Ian-Blockmans/auto-leveling-caravan-prototype/README.md

# auto leveling caravan
prototype met een stm32 controller. prototype werkt maar het is geen afgewerkt product
