Ian-Blockmans/auto-leveling-caravan-prototype/img-vid/IMG_20200525_162942.jpg

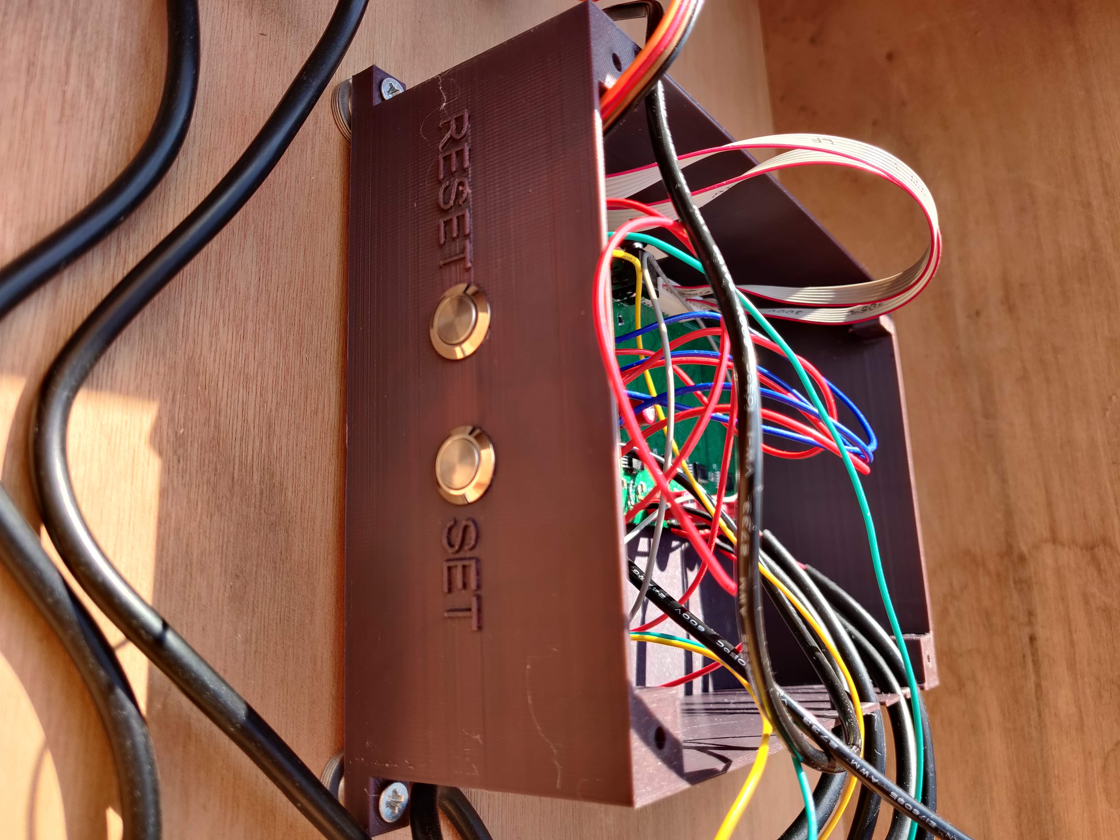
img-vid/IMG_20200525_162942.jpg
