Ian-Blockmans/auto-leveling-caravan-prototype/PART LIST.txt

https://www.mouser.be/ProductDetail/Lelon/REA101M1HBK-0811P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
https://www.mouser.be/ProductDetail/ON-Semiconductor/MM3Z15VST1G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
motor sfh (van jst)
https://www.mouser.be/ProductDetail/CUI-Devices/PJ-082BH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
