Ian-Blockmans/auto-leveling-caravan-prototype/kicad/ent/ent.kicad_pcb

## KiCad design kicad/ent/ent.kicad_pcb (2020-05-05)

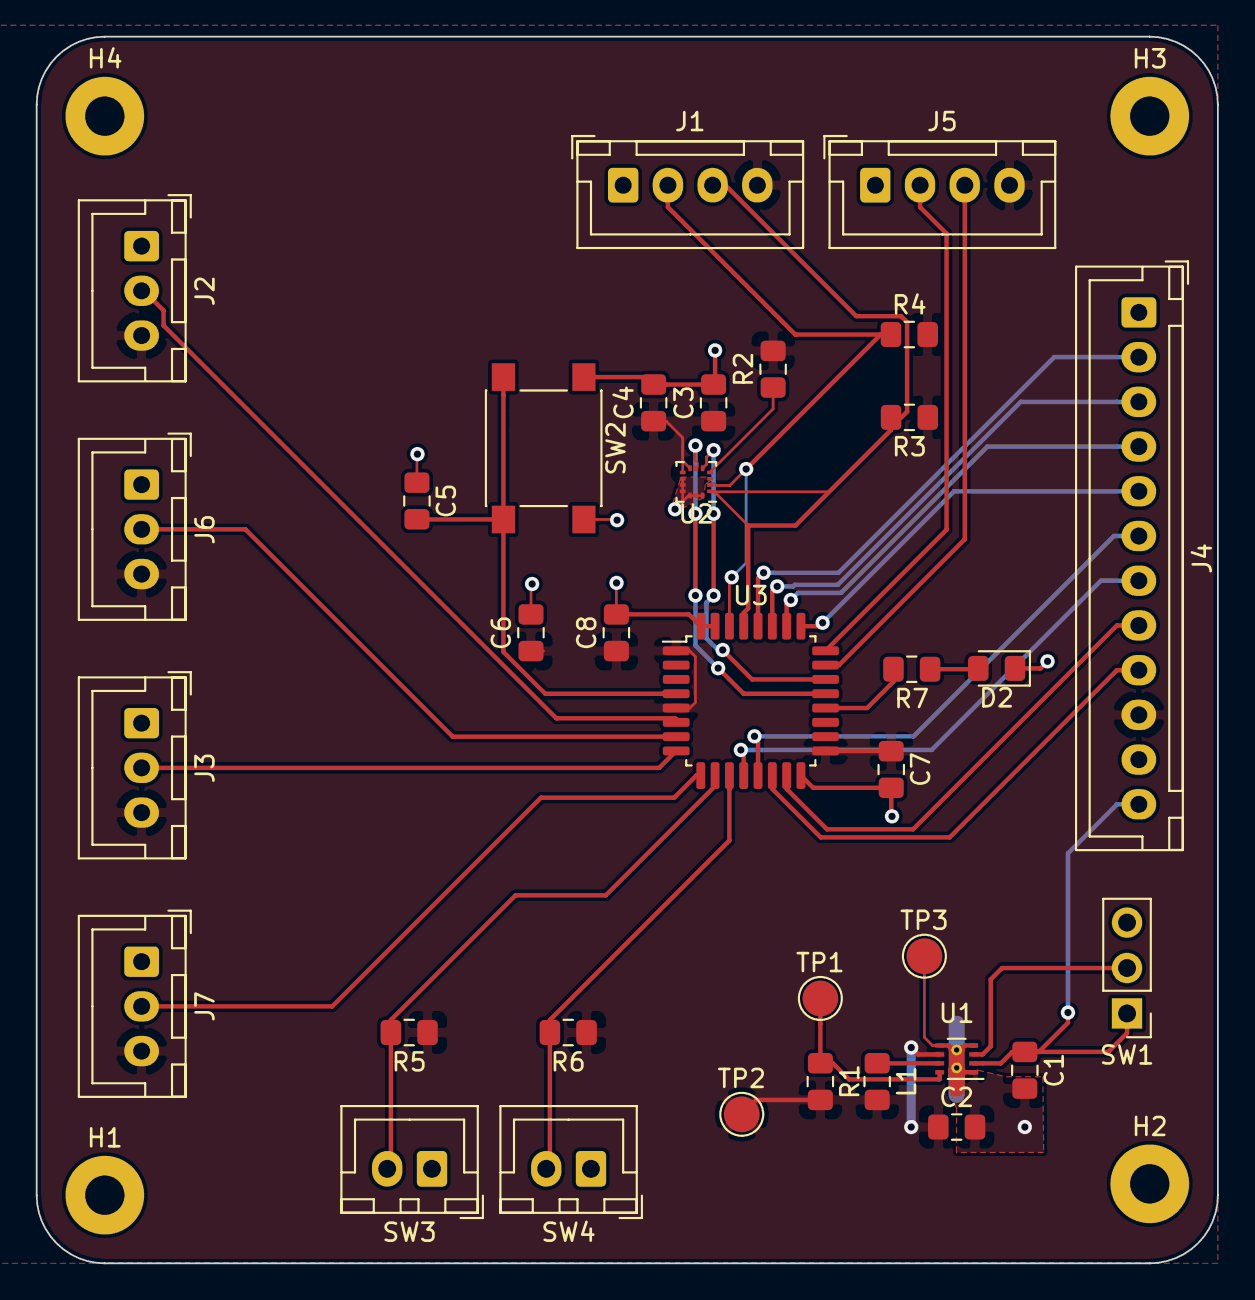
[picture p4: board ent.kicad_pcb from above]

Board: 2 copper layers, 66.0 x 68.6 mm, 38 parts (0 on the bottom side), 30 nets.

Parts:
C1, C3: 10µ; C_0805_2012Metric_Pad1.15x1.40mm_HandSolder
C2: 22µf; C_0805_2012Metric_Pad1.15x1.40mm_HandSolder
C4, C7, C8: 100n; C_0805_2012Metric_Pad1.15x1.40mm_HandSolder
C5: 100nF; C_0805_2012Metric_Pad1.15x1.40mm_HandSolder
C6: 4.7µ; C_0805_2012Metric_Pad1.15x1.40mm_HandSolder
D2: LED; LED_0805_2012Metric_Pad1.15x1.40mm_HandSolder
H1, H2, H3, H4: MountingHole_Pad; MountingHole_2.2mm_M2_Pad
J1, J5: Conn_01x04_Male; JST_XH_B4B-XH-A_1x04_P2.50mm_Vertical
J2, J3, J6, J7: Conn_01x03_Male; JST_XH_B3B-XH-A_1x03_P2.50mm_Vertical
J4: Conn_01x12_Male; JST_XH_B12B-XH-A_1x12_P2.50mm_Vertical
L1: 2.2µH; L_0805_2012Metric_Pad1.15x1.40mm_HandSolder
R1: 100k; R_0805_2012Metric_Pad1.15x1.40mm_HandSolder
R2, R3, R4, R5, R6: 10k; R_0805_2012Metric_Pad1.15x1.40mm_HandSolder
R7: R_Small; R_0805_2012Metric_Pad1.15x1.40mm_HandSolder
SW1: SW_SPDT; PinHeader_1x03_P2.54mm_Vertical
SW2: SW_Push; SW_SPST_PTS645
SW3, SW4: SW_Push; JST_XH_B2B-XH-A_1x02_P2.50mm_Vertical
TP1, TP2, TP3: TestPoint; TestPoint_Pad_D2.0mm
U1: TPS62172DSG; WSON-8-1EP_2x2mm_P0.5mm_EP0.9x1.6mm_ThermalVias
U2: LIS2DHTR; LGA-14_2x2mm_P0.35mm_LayoutBorder3x4y
U3: STM32F030K6Tx; LQFP-32_7x7mm_P0.8mm

Connections:
+12V: C1.1, J4.12, SW1.1, U1.2
Extend: R5.2, SW3.2, U3.10
GND: C1.2, C2.2, C3.2, C4.2, C5.1, C6.2, C7.2, C8.2, D2.1, H1.1, H2.1, H3.1, H4.1, J1.1, J2.1, J3.1, J4.1, J4.11, J5.1, J6.1, J7.1, SW1.3, SW2.1, SW3.1, SW4.1, TP3.1, U1.1, U1.4, U1.5, U1.9, U2.3, U2.9, U2.10, U2.11, U2.12, U2.13, U2.14, U3.16, U3.31, U3.32
INT1: U2.6, U3.21
INT2: U2.5, U3.22
LED: R7.2, U3.20
NSS1: J4.9, U3.14
NSS2: J4.8, U3.15
NSS3: J4.7, U3.12
NSS4: J4.6, U3.13
unnamed: C5.2, SW2.2, U3.4
unnamed: D2.2, R7.1
unnamed: J1.2, R4.1, U2.2, U3.30
unnamed: J1.3, R3.2, U2.1, U3.29
unnamed: J4.5, U3.25
unnamed: L1.1, U1.7
unnamed: R1.1, TP1.1, U1.8
unnamed: R2.1, U2.4
unnamed: SW1.2, U1.3
Retract: R6.2, SW4.2, U3.11
SPI1_MISO: J4.3, U3.27
SPI1_MOSI: J4.2, U3.28
SPI1_SCK: J4.4, U3.26
STOP1: J2.2, U3.6
STOP2: J6.2, U3.7
STOP3: J3.2, U3.8
STOP4: J7.2, U3.9
SWCLK: J5.2, U3.24
SWDIO: J5.3, U3.23
VOS: C2.1, C3.1, C4.1, C6.1, C7.1, C8.1, J1.4, J2.3, J3.3, J4.10, J5.4, J6.3, J7.3, L1.2, R1.2, R2.2, R3.1, R4.2, R5.1, R6.1, TP2.1, U1.6, U2.7, U2.8, U3.1, U3.5, U3.17
