Ian-Blockmans/auto-leveling-caravan-prototype/kicad/ent/motor.kicad_pcb

## KiCad design kicad/ent/motor.kicad_pcb (2020-03-16)

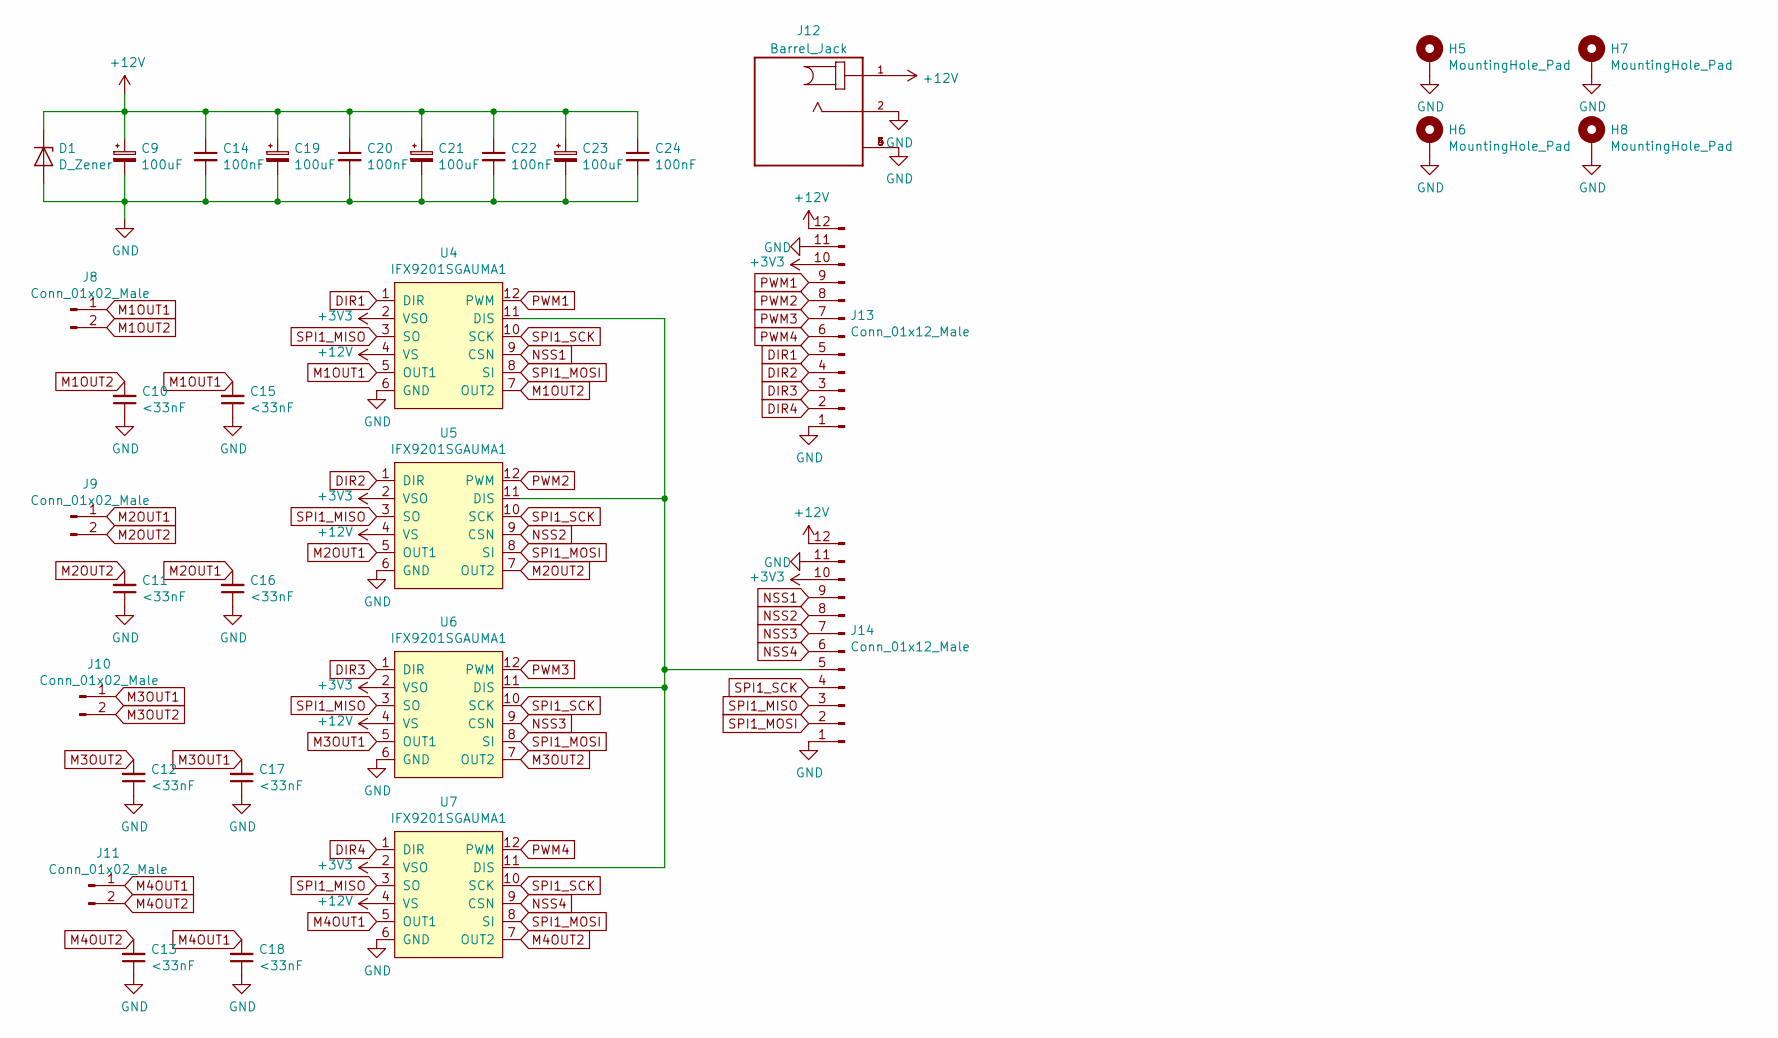
[picture p5: schematic motor.sch]

Parts:
C9, C19, C21, C23: 100uF; CP_Radial_D8.0mm_P3.50mm
C10, C11, C12, C13, C15, C16, C17, C18: <33nF; C_0805_2012Metric_Pad1.15x1.40mm_HandSolder
C14, C20, C22, C24: 100nF; C_0805_2012Metric_Pad1.15x1.40mm_HandSolder
D1: D_Zener; D_SOD-323_HandSoldering
H5, H6, H7, H8: MountingHole_Pad; MountingHole_2.2mm_M2_Pad
J8, J9, J10, J11: Conn_01x02_Male; JST_SFH_SM02B-SFHRS-TF_1x02-1MP_P4.20mm_Horizontal
J12: Barrel_Jack; CUI_PJ-082BH
J13, J14: Conn_01x12_Male; JST_XH_B12B-XH-A_1x12_P2.50mm_Vertical
U4, U5, U6, U7: IFX9201SGAUMA1; PG-DSO-12-17

Connections:
+12V: C9.1, C14.1, C19.1, C20.1, C21.1, C22.1, C23.1, C24.1, D1.1 (K), J12.1, J13.12, J14.12, U4.4 (VS), U5.4 (VS), U6.4 (VS), U7.4 (VS)
DIR1: J13.5, U4.1 (DIR)
DIR2: J13.4, U5.1 (DIR)
DIR3: J13.3, U6.1 (DIR)
DIR4: J13.2, U7.1 (DIR)
GND: C9.2, C10.1, C11.1, C12.1, C13.1, C14.2, C15.1, C16.1, C17.1, C18.1, C19.2, C20.2, C21.2, C22.2, C23.2, C24.2, D1.2 (A), H5.1, H6.1, H7.1, H8.1, J12.2, J12.3 (SHIELD), J12.4 (SHIELD), J12.5 (SHIELD), J12.6 (SHIELD), J12.7, J13.1, J13.11, J14.1, J14.11, U4.6 (GND), U4.13, U5.6 (GND), U5.13, U6.6 (GND), U6.13, U7.6 (GND), U7.13
M1OUT1: C15.2, J8.1, U4.5 (OUT1)
M1OUT2: C10.2, J8.2, U4.7 (OUT2)
M2OUT1: C16.2, J9.1, U5.5 (OUT1)
M2OUT2: C11.2, J9.2, U5.7 (OUT2)
M3OUT1: C17.2, J10.1, U6.5 (OUT1)
M3OUT2: C12.2, J10.2, U6.7 (OUT2)
M4OUT1: C18.2, J11.1, U7.5 (OUT1)
M4OUT2: C13.2, J11.2, U7.7 (OUT2)
NSS1: J14.9, U4.9 (CSN)
NSS2: J14.8, U5.9 (CSN)
NSS3: J14.7, U6.9 (CSN)
NSS4: J14.6, U7.9 (CSN)
unnamed: J14.5, U4.11 (DIS), U5.11 (DIS), U6.11 (DIS), U7.11 (DIS)
PWM1: J13.9, U4.12 (PWM)
PWM2: J13.8, U5.12 (PWM)
PWM3: J13.7, U6.12 (PWM)
PWM4: J13.6, U7.12 (PWM)
SPI1_MISO: J14.3, U4.3 (SO), U5.3 (SO), U6.3 (SO), U7.3 (SO)
SPI1_MOSI: J14.2, U4.8 (SI), U5.8 (SI), U6.8 (SI), U7.8 (SI)
SPI1_SCK: J14.4, U4.10 (SCK), U5.10 (SCK), U6.10 (SCK), U7.10 (SCK)
VOS: J13.10, J14.10, U4.2 (VSO), U5.2 (VSO), U6.2 (VSO), U7.2 (VSO)

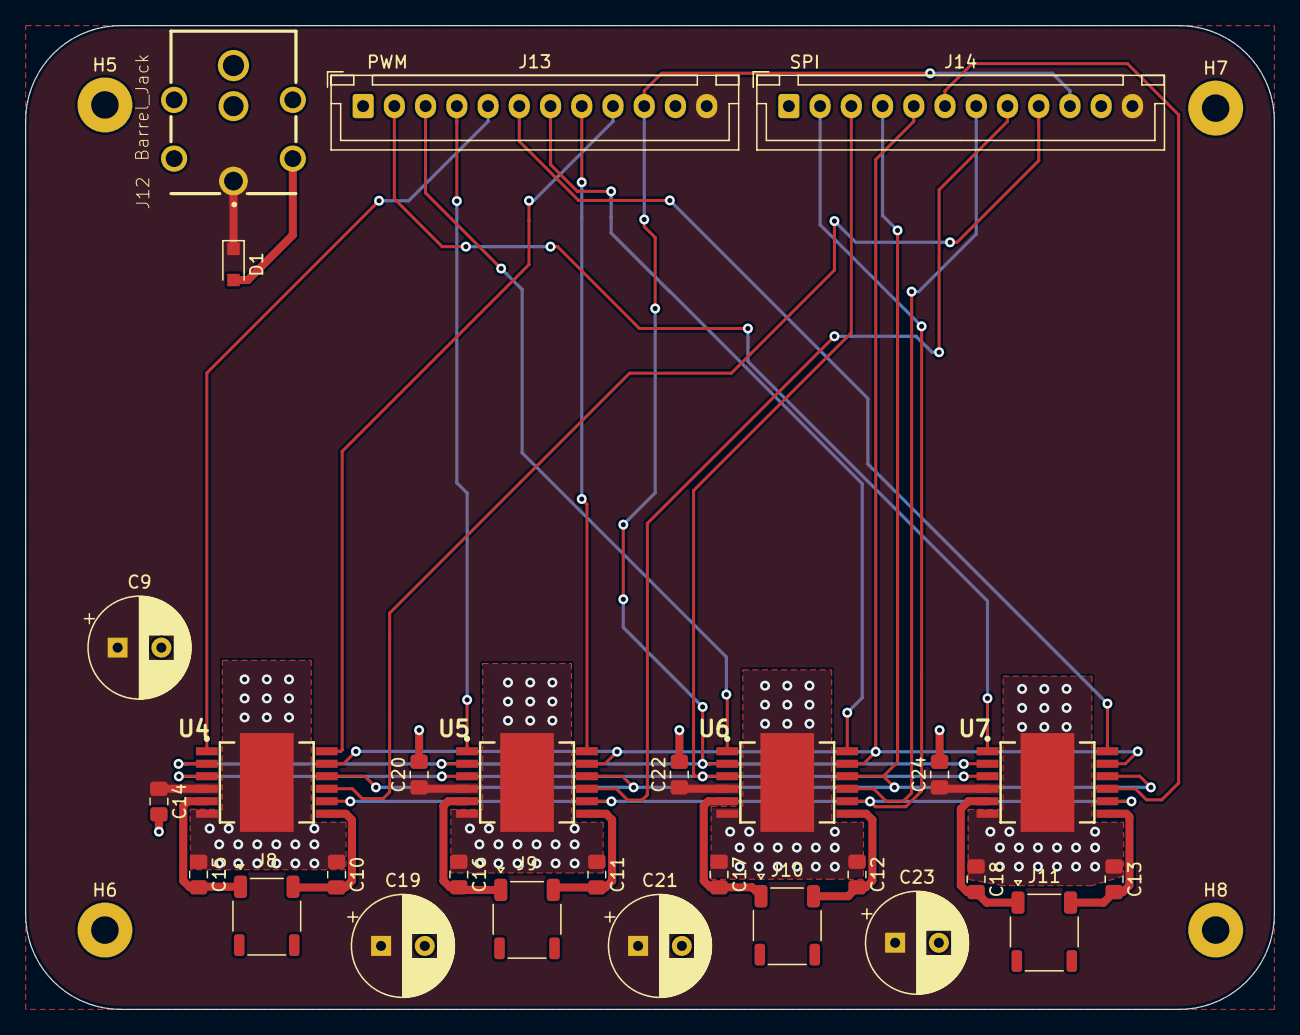
[picture p6: board motor.kicad_pcb from above]

Board: 2 copper layers, 99.9 x 78.7 mm, 32 parts (0 on the bottom side), 27 nets.
