Ian-Blockmans/auto-leveling-caravan-prototype/software/F030/Src/main.c

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

/* Includes ------------------------------------------------------------------*/
#include "main.h"

/* USER CODE BEGIN PTD */
typedef struct accel {
	int8_t x;
	int8_t y;
	int8_t z;
} acc;

typedef enum error {
	OK = 0, TIMEOUT = 1,
} err;
/* USER CODE END PTD */

I2C_HandleTypeDef hi2c1;

TIM_HandleTypeDef htim3;
TIM_HandleTypeDef htim14;

void SystemClock_Config(void);
static void MX_GPIO_Init(void);
static void MX_TIM3_Init(void);
static void MX_I2C1_Init(void);
static void MX_TIM14_Init(void);
/* USER CODE BEGIN PFP */
acc readacc();
err legstoground();
void c_back_right(uint8_t dir, uint8_t onoff);
void c_back_left(uint8_t dir, uint8_t onoff);
void c_front_right(uint8_t dir, uint8_t onoff);
void c_front_left(uint8_t dir, uint8_t onoff);
err fronttoback();
uint8_t lefttoright();

/* USER CODE END PFP */

/* USER CODE BEGIN 0 */

uint8_t timeout = 0;

void HAL_TIM_PeriodElapsedCallback(TIM_HandleTypeDef *htim) {
	if (htim->Instance == htim14.Instance) {
		timeout = 1;
	}
}

acc readacc() {
	acc axis;
	uint8_t i2cbuffer[8];
	HAL_StatusTypeDef ok = HAL_ERROR;
	//i2cbuffer[0] = 0x28;
	//HAL_I2C_Master_Transmit(&hi2c1,0b0011001<<1,i2cbuffer,1,500);//ask
	//HAL_I2C_Master_Receive(&hi2c1,0b00110011,i2cbuffer,6,500);//get
	while (ok != HAL_OK) {
		ok = HAL_I2C_Mem_Read(&hi2c1, 0b00110010, 0x29, I2C_MEMADD_SIZE_8BIT,
				&i2cbuffer[0], 1, HAL_MAX_DELAY);
	}
	ok = HAL_ERROR;
	while (ok != HAL_OK) {
		ok = HAL_I2C_Mem_Read(&hi2c1, 0b00110010, 0x2b, I2C_MEMADD_SIZE_8BIT,
				&i2cbuffer[1], 1, HAL_MAX_DELAY);
	}
	ok = HAL_ERROR;
	while (ok != HAL_OK) {
		ok = HAL_I2C_Mem_Read(&hi2c1, 0b00110010, 0x2d, I2C_MEMADD_SIZE_8BIT,
				&i2cbuffer[2], 1, HAL_MAX_DELAY);
	}
	//HAL_GPIO_TogglePin(GPIOC,GPIO_PIN_13);
	axis.x = i2cbuffer[0];
	axis.y = i2cbuffer[1];
	axis.z = i2cbuffer[2];
	return axis;
}

err legstoground() {
	acc pos;
	acc init_pos;
	uint8_t kantel_count = 0;
	init_pos = readacc();
	pos = readacc();
	HAL_Delay(1000);
	if (init_pos.y > -3) {
		//start front motors
		init_pos = readacc();
		pos = readacc();
		HAL_TIM_Base_Start_IT(&htim14);
		while (init_pos.y - 2 < pos.y) {
			HAL_GPIO_WritePin(GPIOA, GPIO_PIN_10, 0);
			c_front_left(1, 1);
			HAL_Delay(500);
			c_front_left(1, 0);
			HAL_Delay(500);
			HAL_GPIO_WritePin(GPIOA, GPIO_PIN_10, 1);
			HAL_Delay(500);
			pos = readacc();
			HAL_Delay(1000);
			//wacht tot de grond is geraakt
			if (timeout == 1 || HAL_GPIO_ReadPin(GPIOA, GPIO_PIN_5) == 0) {
				HAL_TIM_Base_Stop_IT(&htim14);
				TIM14->CNT = 0;
				timeout = 0;
				return TIMEOUT;
			}
		}
		HAL_TIM_Base_Stop_IT(&htim14);
		TIM14->CNT = 0;
		c_front_left(0, 1);
		HAL_Delay(500);
		c_front_left(0, 0);
		HAL_Delay(1000);

		init_pos = readacc();
		pos = readacc();
		HAL_TIM_Base_Start_IT(&htim14);
		while (init_pos.y - 2 < pos.y) {
			HAL_GPIO_WritePin(GPIOA, GPIO_PIN_10, 0);
			c_front_right(1, 1);
			HAL_Delay(500);
			c_front_right(1, 0);
			HAL_Delay(500);
			HAL_GPIO_WritePin(GPIOA, GPIO_PIN_10, 1);
			HAL_Delay(500);
			pos = readacc();
			HAL_Delay(1000);
			////wacht tot de grond is geraakt
			if (timeout == 1 || HAL_GPIO_ReadPin(GPIOA, GPIO_PIN_5) == 0) {
				HAL_TIM_Base_Stop_IT(&htim14);
				TIM14->CNT = 0;
				timeout = 0;
				return TIMEOUT;
			}
		}
		HAL_TIM_Base_Stop_IT(&htim14);
		TIM14->CNT = 0;
		c_front_right(0, 1);
		HAL_Delay(500);
		c_front_right(0, 0);

		//kantel
		pos = readacc();
		HAL_TIM_Base_Start_IT(&htim14);
		while (pos.y > -10) {
			HAL_GPIO_WritePin(GPIOA, GPIO_PIN_10, 0);
			c_front_left(1, 1);
			c_front_right(1, 1);
			HAL_Delay(500);
			c_front_left(1, 0);
			c_front_right(1, 0);
			HAL_Delay(500);
			HAL_GPIO_WritePin(GPIOA, GPIO_PIN_10, 1);
			HAL_Delay(500);
			pos = readacc();
			HAL_Delay(1000);
			kantel_count++;
			if (timeout == 1 || HAL_GPIO_ReadPin(GPIOA, GPIO_PIN_5) == 0) {
				HAL_TIM_Base_Stop_IT(&htim14);
				TIM14->CNT = 0;
				timeout = 0;
				return TIMEOUT;
			}
		}
		HAL_TIM_Base_Stop_IT(&htim14);
		TIM14->CNT = 0;
		c_front_left(0, 1);
		c_front_right(0, 1);
		HAL_Delay(500);
		c_front_left(0, 0);
		c_front_right(0, 0);
		HAL_Delay(2000);

		//start back
		init_pos = readacc();
		pos = readacc();
		HAL_TIM_Base_Start_IT(&htim14);
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
			HAL_Delay(1200);
			pos = readacc();
			HAL_Delay(1000);
			if (timeout == 1 || HAL_GPIO_ReadPin(GPIOA, GPIO_PIN_5) == 0) {
				HAL_TIM_Base_Stop_IT(&htim14);
				TIM14->CNT = 0;
				timeout = 0;
				return TIMEOUT;
			}

		}
	}
	HAL_TIM_Base_Stop_IT(&htim14);
	TIM14->CNT = 0;
	return OK;
}

uint8_t lefttoright() {
	acc pos;
	uint8_t last_up = 0; //1 = right | 2 = left
//front fix
	pos = readacc();
	HAL_TIM_Base_Start_IT(&htim14);
	while (pos.x < -1 || pos.x > 1) {
		HAL_GPIO_WritePin(GPIOA, GPIO_PIN_10, 0);
		if (pos.x < 0) {
			c_front_right(1, 1);
			c_back_right(1, 1);
			HAL_Delay(200);
			c_front_right(1, 0);
			c_back_right(1, 0);
			HAL_Delay(800);
			HAL_GPIO_WritePin(GPIOA, GPIO_PIN_10, 1);
			HAL_Delay(1200);
			pos = readacc();
			HAL_Delay(1000);
			last_up = 1;
		} else {
			c_front_left(1, 1);
			c_back_left(1, 1);
			HAL_Delay(200);
			c_front_left(1, 0);
			c_back_left(1, 0);
			HAL_Delay(800);
			HAL_GPIO_WritePin(GPIOA, GPIO_PIN_10, 1);
			HAL_Delay(1200);
			pos = readacc();
			HAL_Delay(1000);
			last_up = 2;
		}
		if (timeout == 1 || HAL_GPIO_ReadPin(GPIOA, GPIO_PIN_5) == 0) {
			HAL_TIM_Base_Stop_IT(&htim14);
			TIM14->CNT = 0;
			timeout = 0;
			return 0;
		}
	}
	HAL_TIM_Base_Stop_IT(&htim14);
	TIM14->CNT = 0;
	return last_up;
}

err legs_down_last(uint8_t leg_fix) {
	acc pos, init_pos;
	init_pos = readacc();
	pos = readacc();
	if (leg_fix == 1) {
		HAL_TIM_Base_Start_IT(&htim14);
		while (init_pos.x - 2 < pos.x) {
			HAL_GPIO_WritePin(GPIOA, GPIO_PIN_10, 0);
			c_front_left(1, 1);
			c_back_left(1, 1);
			HAL_Delay(500);
			c_front_left(1, 0);
			c_back_left(1, 0);
			HAL_Delay(800);
			HAL_GPIO_WritePin(GPIOA, GPIO_PIN_10, 1);
			HAL_Delay(1200);
			pos = readacc();
			HAL_Delay(1000);
			if (timeout == 1 || HAL_GPIO_ReadPin(GPIOA, GPIO_PIN_5) == 0) {
				HAL_TIM_Base_Stop_IT(&htim14);
				TIM14->CNT = 0;
				timeout = 0;
				return TIMEOUT;
			}
		}
		HAL_TIM_Base_Stop_IT(&htim14);
		TIM14->CNT = 0;
	} else if (leg_fix == 2) {
		HAL_TIM_Base_Start_IT(&htim14);
		while (init_pos.x + 2 > pos.x) {
			HAL_GPIO_WritePin(GPIOA, GPIO_PIN_10, 0);
			c_front_right(1, 1);
			c_back_right(1, 1);
			HAL_Delay(500);
			c_front_right(1, 0);
			c_back_right(1, 0);
			HAL_Delay(800);
			HAL_GPIO_WritePin(GPIOA, GPIO_PIN_10, 1);
			HAL_Delay(1200);
			pos = readacc();
			HAL_Delay(1000);
			if (timeout == 1 || HAL_GPIO_ReadPin(GPIOA, GPIO_PIN_5) == 0) {
				HAL_TIM_Base_Stop_IT(&htim14);
				TIM14->CNT = 0;
				timeout = 0;
				return TIMEOUT;
			}
		}
		HAL_TIM_Base_Stop_IT(&htim14);
		TIM14->CNT = 0;
	} else {
	}
	return OK;
}

void c_back_right(uint8_t dir, uint8_t onoff) {
	HAL_GPIO_WritePin(GPIOA, GPIO_PIN_15, dir);
	if (onoff == 1) {
		HAL_TIM_PWM_Start(&htim3, TIM_CHANNEL_3);
	} else {
		HAL_TIM_PWM_Stop(&htim3, TIM_CHANNEL_3);
	}
}

void c_front_right(uint8_t dir, uint8_t onoff) {
	HAL_GPIO_WritePin(GPIOB, GPIO_PIN_4, dir);
	if (onoff == 1) {
		HAL_TIM_PWM_Start(&htim3, TIM_CHANNEL_1);
	} else {
		HAL_TIM_PWM_Stop(&htim3, TIM_CHANNEL_1);
	}
}

void c_front_left(uint8_t dir, uint8_t onoff) {
	HAL_GPIO_WritePin(GPIOB, GPIO_PIN_5, dir);
	if (onoff == 1) {
		HAL_TIM_PWM_Start(&htim3, TIM_CHANNEL_2);
	} else {
		HAL_TIM_PWM_Stop(&htim3, TIM_CHANNEL_2);
	}
}

void c_back_left(uint8_t dir, uint8_t onoff) {
	HAL_GPIO_WritePin(GPIOB, GPIO_PIN_3, dir);
	if (onoff == 1) {
		HAL_TIM_PWM_Start(&htim3, TIM_CHANNEL_4);
	} else {
		HAL_TIM_PWM_Stop(&htim3, TIM_CHANNEL_4);
	}
}

uint8_t debounce100(GPIO_TypeDef* GPIOx, uint16_t GPIO_Pin) {
	uint8_t counter = 0, timeout = 0, last_state = 0;
	HAL_Delay(1);
	if (HAL_GPIO_ReadPin(GPIOx, GPIO_Pin) == 0) {
		while (counter < 100) {
			timeout++;
			if (HAL_GPIO_ReadPin(GPIOx, GPIO_Pin) == last_state) {
				counter++;
			} else {
				counter = 0;
			}
			last_state = HAL_GPIO_ReadPin(GPIOx, GPIO_Pin);
			if (timeout == 500) {
				break;
			}
		}
		if (counter == 100) {
			return 1;
		} else {
			return 0;
		}
	} else {
		return 0;
	}
}

void init() {
	uint8_t buffer[8];
	buffer[0] = 0x20;
	buffer[1] = 0b01000111;
	HAL_StatusTypeDef status;
	status = HAL_I2C_Master_Transmit(&hi2c1, 0b0011001 << 1, buffer, 2, 500);
	while (status != HAL_OK) {
		status = HAL_I2C_Master_Transmit(&hi2c1, 0b0011000 << 1, buffer, 2,
				HAL_MAX_DELAY);
	}	// config acc

	// initial false interupt fix
	HAL_TIM_Base_Start_IT(&htim14);
	HAL_Delay(10);
	HAL_TIM_Base_Stop_IT(&htim14);
	TIM14->CNT = 0;
	timeout = 0;
}
/* USER CODE END 0 */

/**
 * @brief  The application entry point.
 * @retval int
 */
int main(void) {
	/* MCU Configuration--------------------------------------------------------*/

	/* Reset of all peripherals, Initializes the Flash interface and the Systick. */
	HAL_Init();

	/* Configure the system clock */
	SystemClock_Config();

	/* Initialize all configured peripherals */
	MX_GPIO_Init();
	MX_TIM3_Init();
	MX_I2C1_Init();
	MX_TIM14_Init();
	/* USER CODE BEGIN 2 */
	init();

	uint8_t leg_fix;
	err status_legs;
	/* USER CODE END 2 */

	/* Infinite loop */
	/* USER CODE BEGIN WHILE */
	while (1) {
		/* USER CODE END WHILE */

		/* USER CODE BEGIN 3 */
		if (debounce100(GPIOA, GPIO_PIN_4)) {
			HAL_GPIO_WritePin(GPIOA, GPIO_PIN_10, 0);
			status_legs = legstoground();
			if (status_legs == OK) {
				status_legs = fronttoback();
				if (status_legs == OK) {
					leg_fix = lefttoright();
					if (leg_fix > 0) {
						legs_down_last(leg_fix);
						status_legs = fronttoback();
						if (status_legs == OK) {
							leg_fix = lefttoright();
							if (leg_fix == 0) {
								legsup();
							} else {
								HAL_GPIO_WritePin(GPIOA, GPIO_PIN_10, 1);
							}
						} else {
							legsup();
						}
					} else {
						legsup();
					}
				} else {
					legsup();
				}
			} else {
				legsup();
			}
		}
		if (debounce100(GPIOA, GPIO_PIN_5)) {
			legsup();
		}

	}
	/* USER CODE END 3 */
}

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
