Ian-Blockmans/auto-leveling-caravan-prototype/(commit log)

2020-02-14 stert bestanden
    [acctestf1 Debug.cfg, ent.kicad_pcb, ent.sch, testaccf7 Run.cfg]
2020-03-05 updated schema
    [ent.sch]
2020-03-05 schema main done
    [ent.sch, motor.sch]
2020-03-05 + motor drivers
    [ent.sch]
2020-03-06 Caps bij motor drivers
    [ent.sch]
2020-03-06 footprints
    alles behalve power/motor connectors
    [motor.sch]
2020-03-08 begin pcb
    [ent.kicad_pcb, ent.sch, motor.kicad_pcb, motor.sch]
2020-03-11 added interface buttons
    enkel schema
    [ent.sch]
2020-03-16 barreljack footprint update
    naar de footprint van mouser veranderd
    [motor.kicad_pcb]
2020-03-16 pcb done
    [ent.kicad_pcb, ent.sch, motor.kicad_pcb, motor.sch]
2020-05-05 software
    functioneel
    [F030 Debug.cfg, acctestf1 Run.cfg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]
