Ian-Blockmans/auto-leveling-caravan-prototype/img-vid/IMG_20200526_144828.jpg

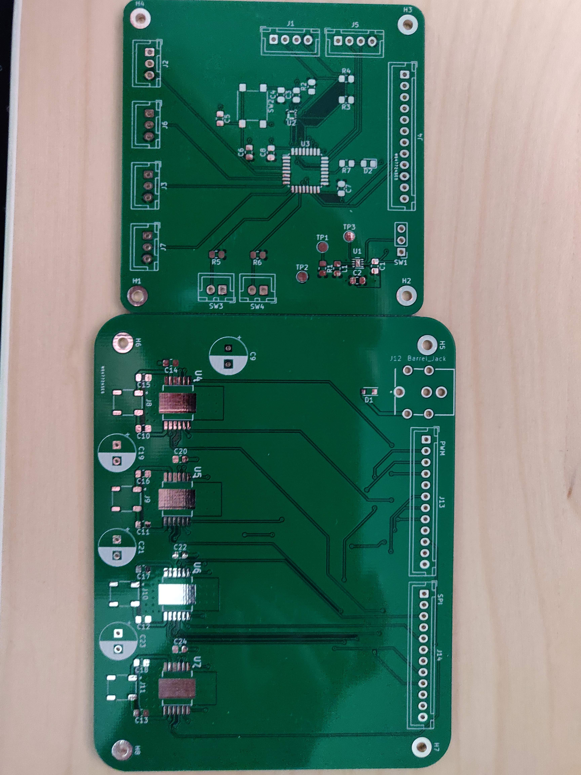
img-vid/IMG_20200526_144828.jpg
